HexSense-MIT/HS_ESP32_CAM_module/README.md

# HS_ESP32_CAM_module

A custom designed USB camera module, with ESP32-S3R8 + OV2640. This will be used for the HexSense_CAM payload.
