HexSense-MIT/HS_ESP32_CAM_module/Docs/camera_pwr_consum.png

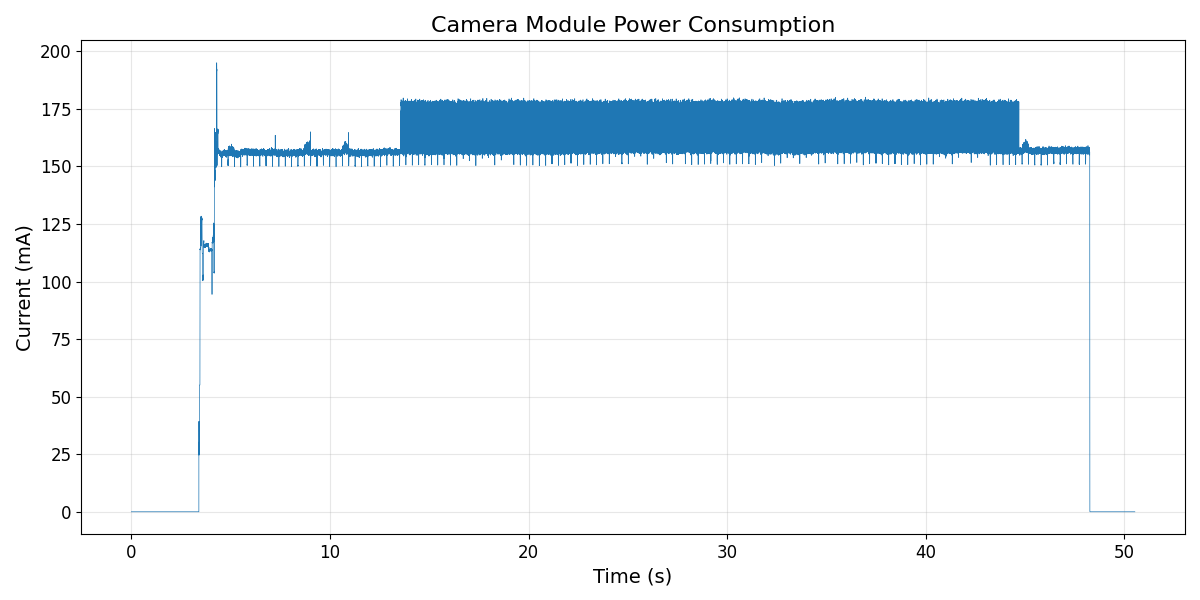
Docs/camera_pwr_consum.png
