HexSense-MIT/HS_ESP32_CAM_module/GUI/control_cam/1 - 5.tif

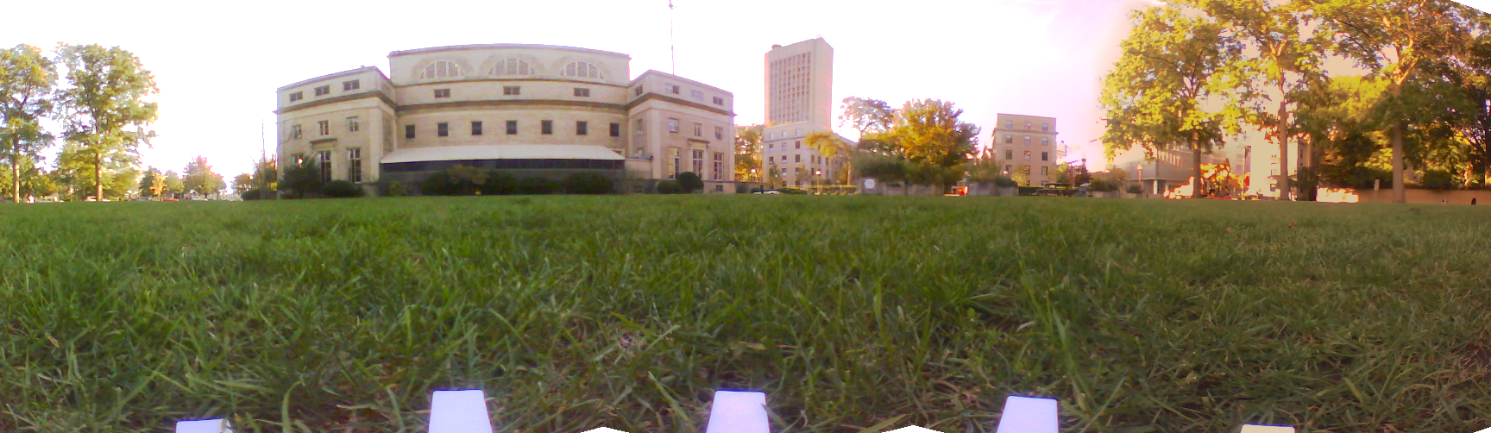
GUI/control_cam/1 - 5.tif
