HexSense-MIT/HS_ESP32_CAM_module/GUI/control_cam/images/1/02.jpg

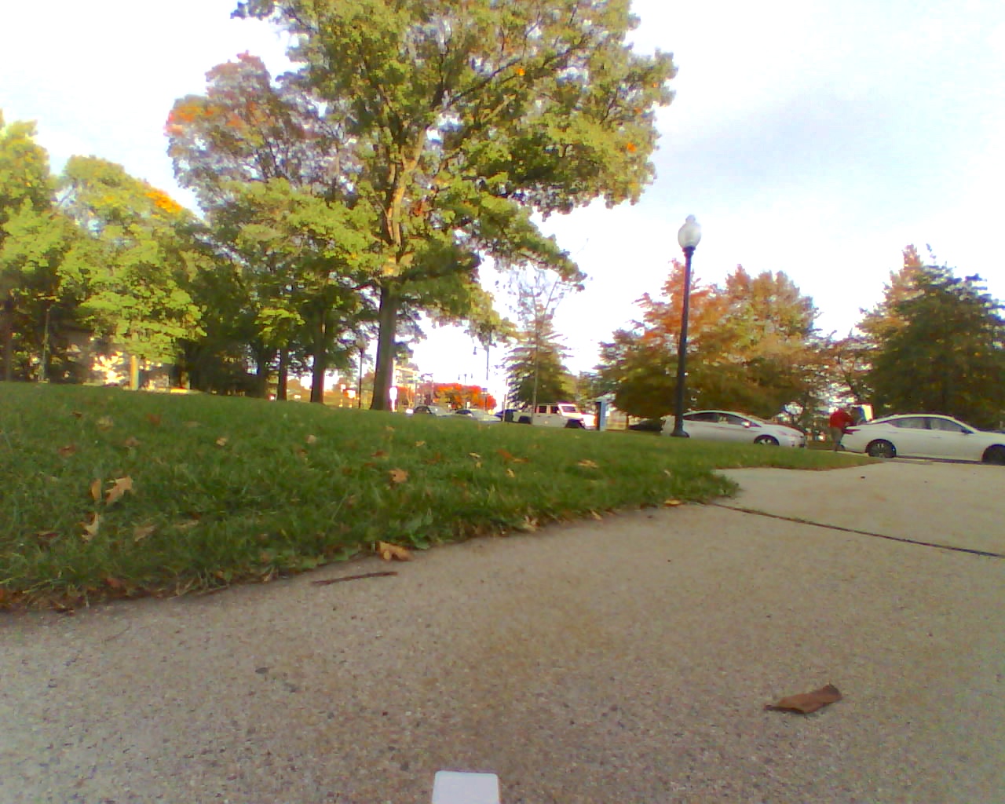
GUI/control_cam/images/1/02.jpg
