HexSense-MIT/HS_ESP32_CAM_module/GUI/control_cam/images/1/06.jpg

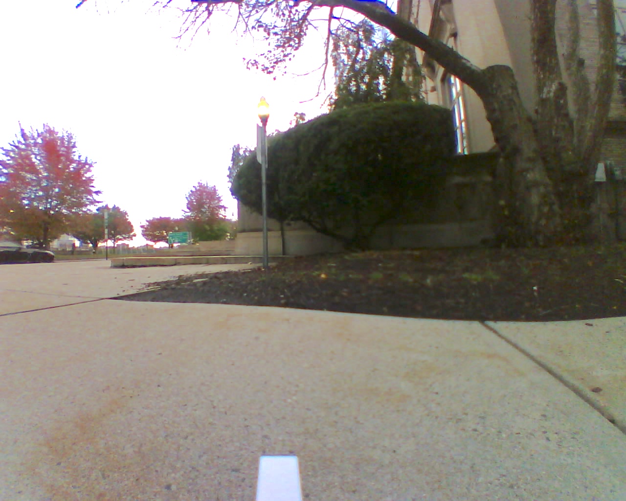
GUI/control_cam/images/1/06.jpg
