HexSense-MIT/HS_ESP32_CAM_module/GUI/control_cam/images/2/13.jpg

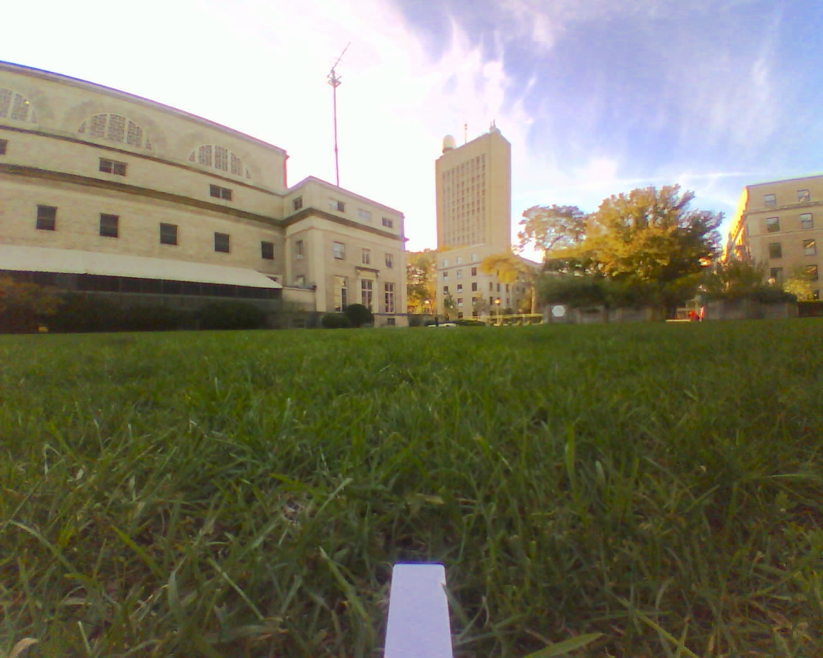
GUI/control_cam/images/2/13.jpg
