HexSense-MIT/HS_ESP32_CAM_module/GUI/control_cam/images/lab_open_desk/10.jpg

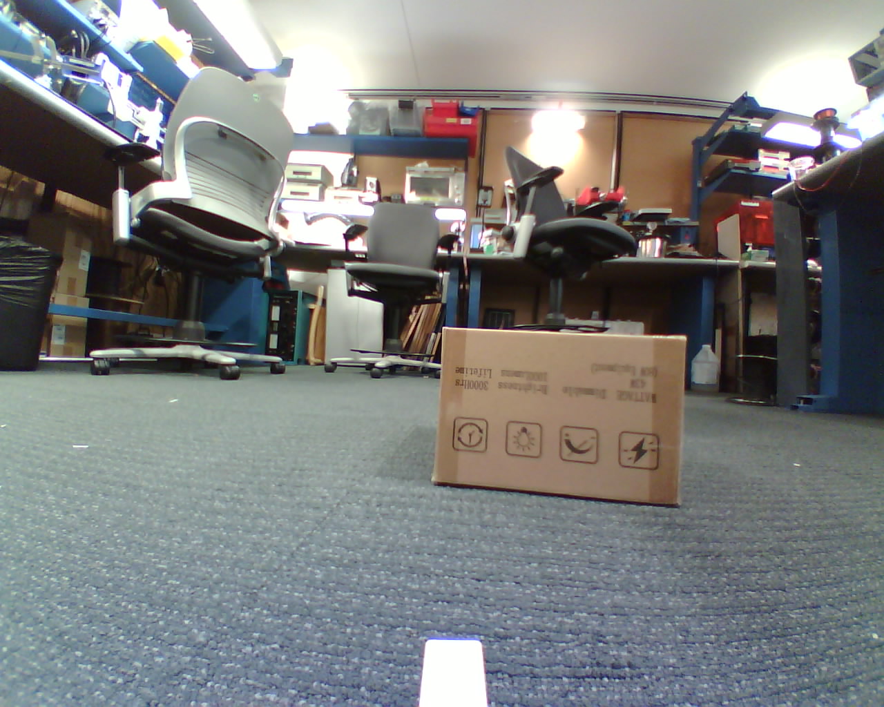
GUI/control_cam/images/lab_open_desk/10.jpg
