HexSense-MIT/HS_ESP32_CAM_module/GUI/control_cam/images/MIT.jpg

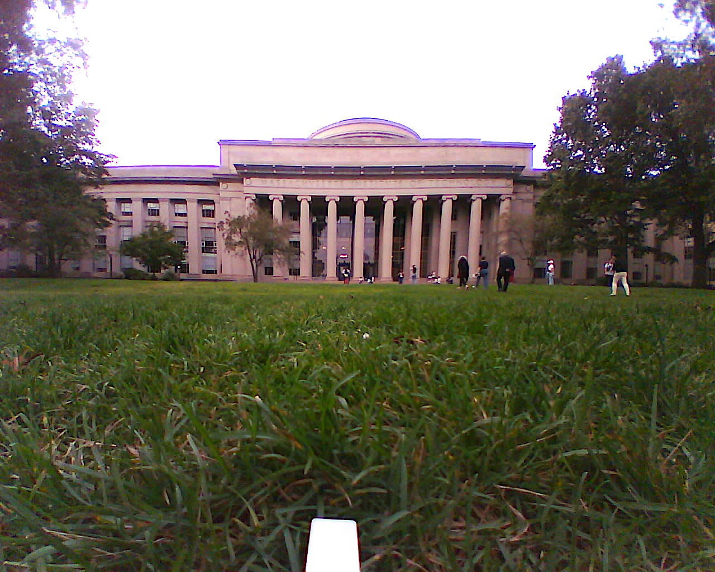
GUI/control_cam/images/MIT.jpg
