HexSense-MIT/HS_ESP32_CAM_module/GUI/control_cam/images/parkinglot/11.jpg

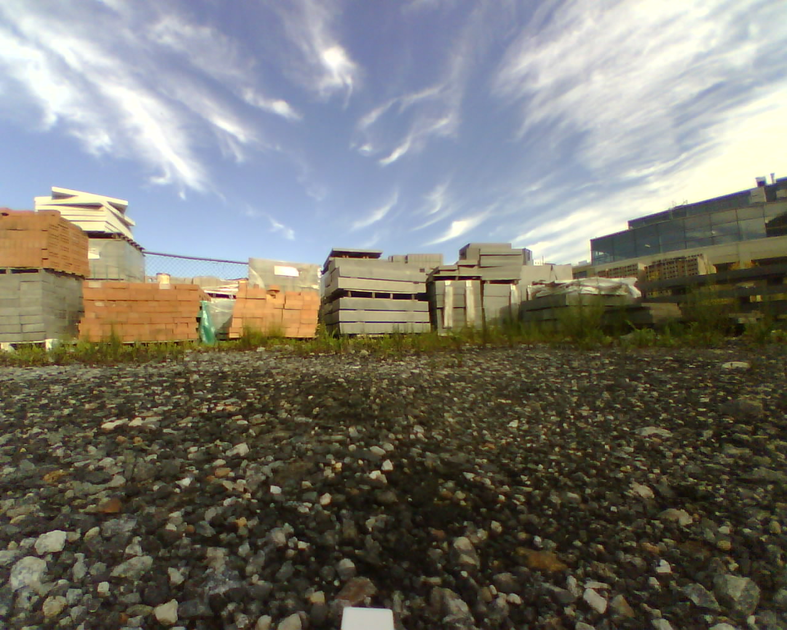
GUI/control_cam/images/parkinglot/11.jpg
