HexSense-MIT/HS_ESP32_CAM_module/GUI/control_cam/images/parkinglot/19.jpg

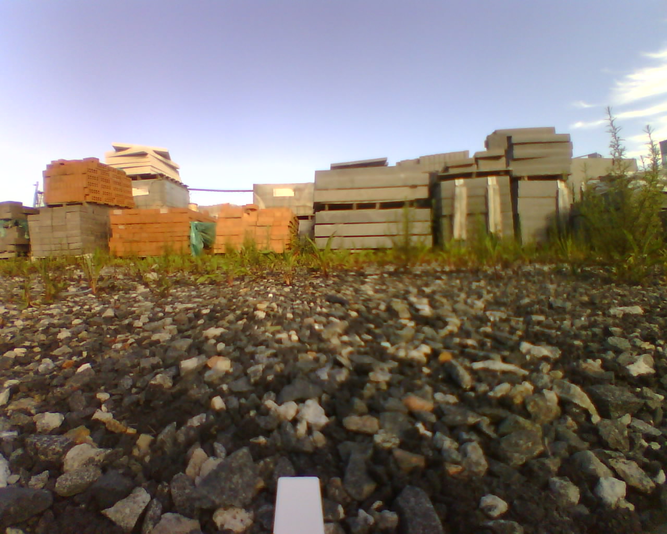
GUI/control_cam/images/parkinglot/19.jpg
