HexSense-MIT/HS_ESP32_CAM_module/GUI/control_cam/output_image.jpg

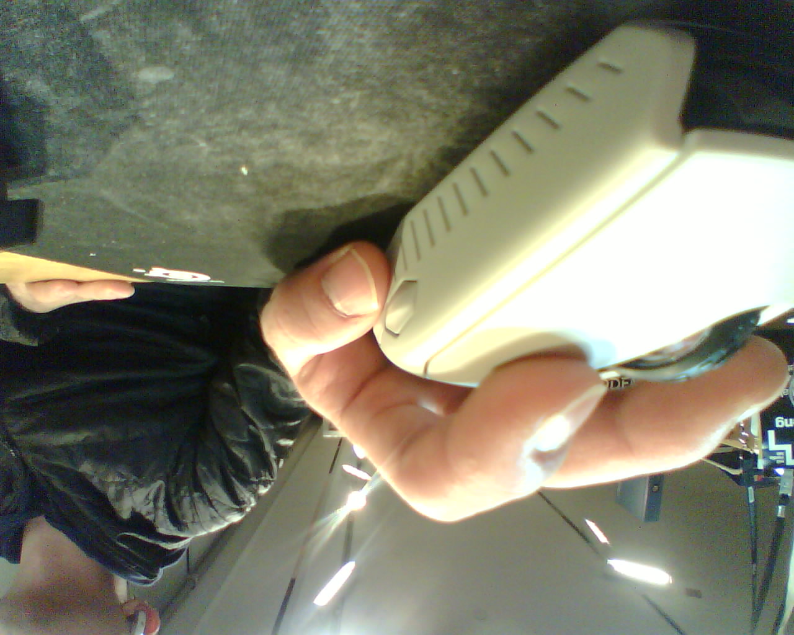
GUI/control_cam/output_image.jpg
