HexSense-MIT/HS_ESP32_CAM_module/GUI/control_cam/xy.jpeg

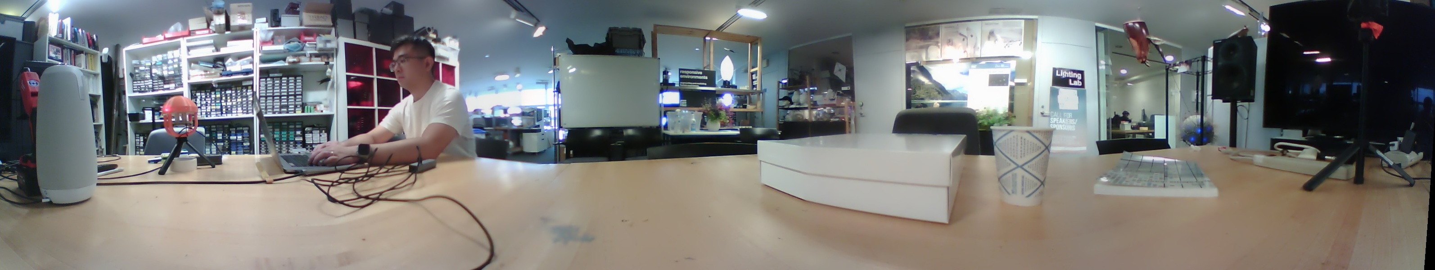
GUI/control_cam/xy.jpeg
