HexSense-MIT/HS_ESP32_CAM_module/GUI/moonpano/1/0.jpg

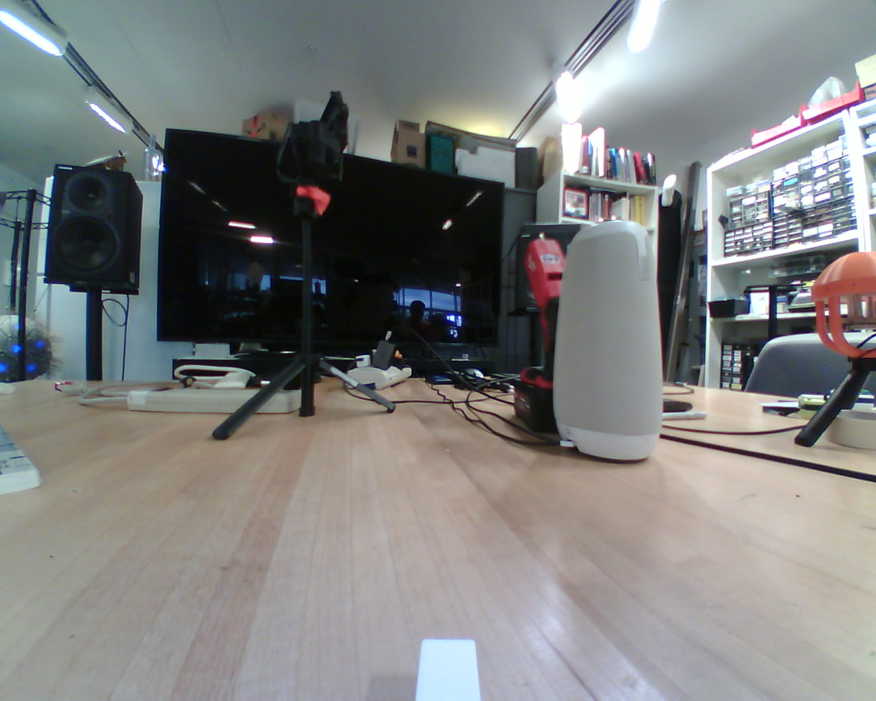
GUI/moonpano/1/0.jpg
