HexSense-MIT/HS_ESP32_CAM_module/GUI/moonpano/1/1.jpg

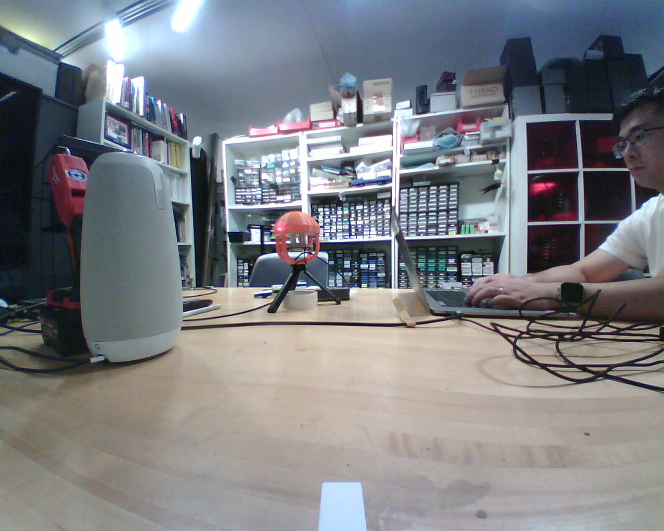
GUI/moonpano/1/1.jpg
