HexSense-MIT/HS_ESP32_CAM_module/GUI/moonpano/calib.jpg

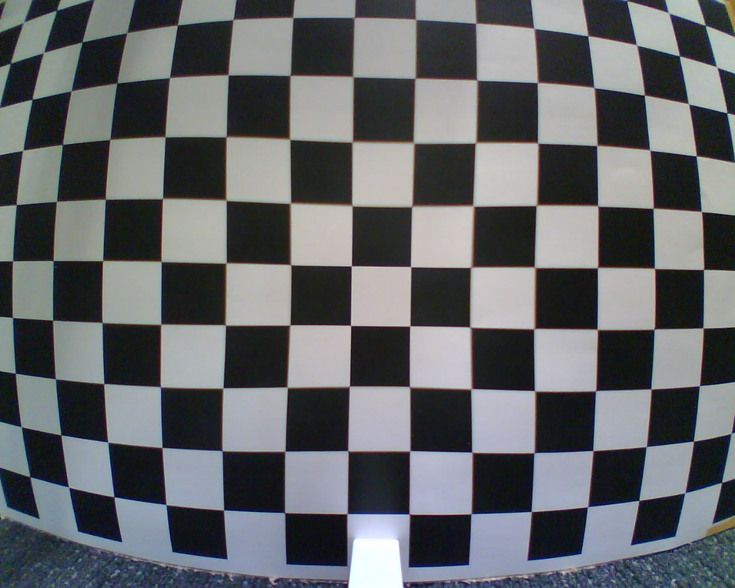
GUI/moonpano/calib.jpg
