HexSense-MIT/HS_ESP32_CAM_module/GUI/moonpano/map.png

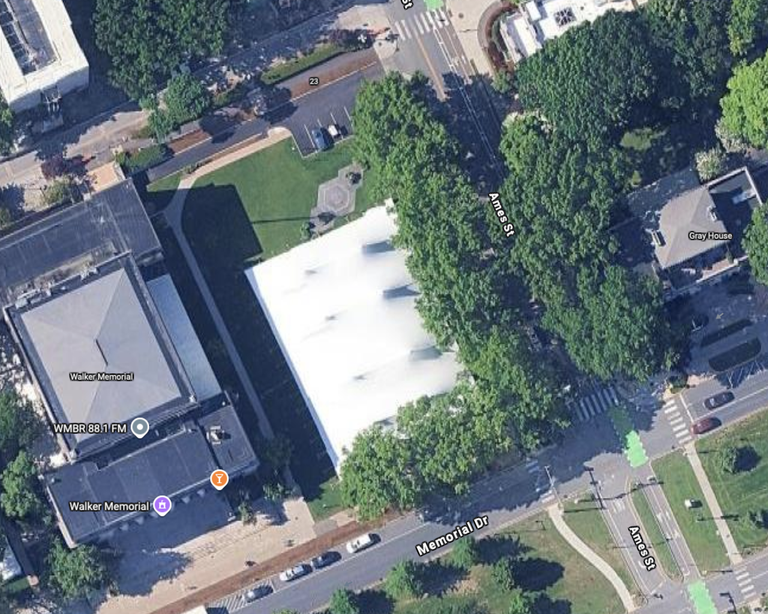
GUI/moonpano/map.png
