HexSense-MIT/HS_ESP32_CAM_module/GUI/control_cam/calibration/cali_code/9.jpg

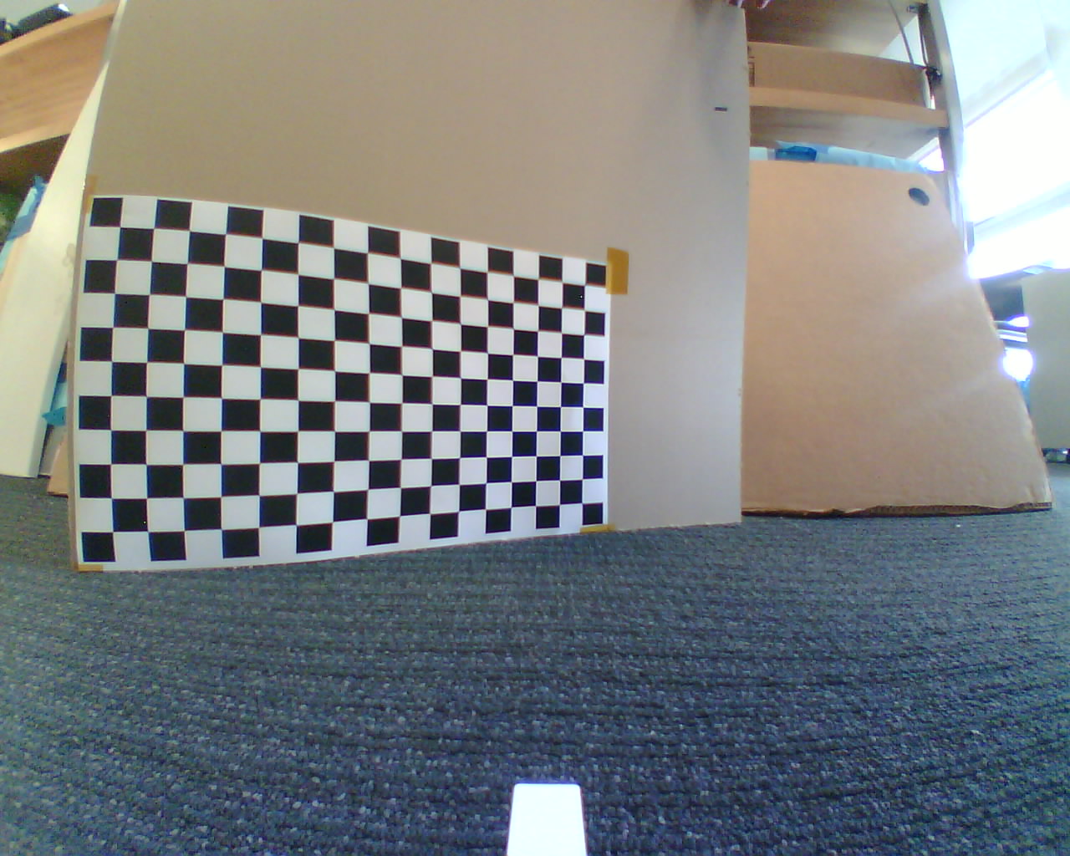
GUI/control_cam/calibration/cali_code/9.jpg
