HexSense-MIT/HS_ESP32_CAM_module/GUI/control_cam/calibration/cali_code/23.jpg

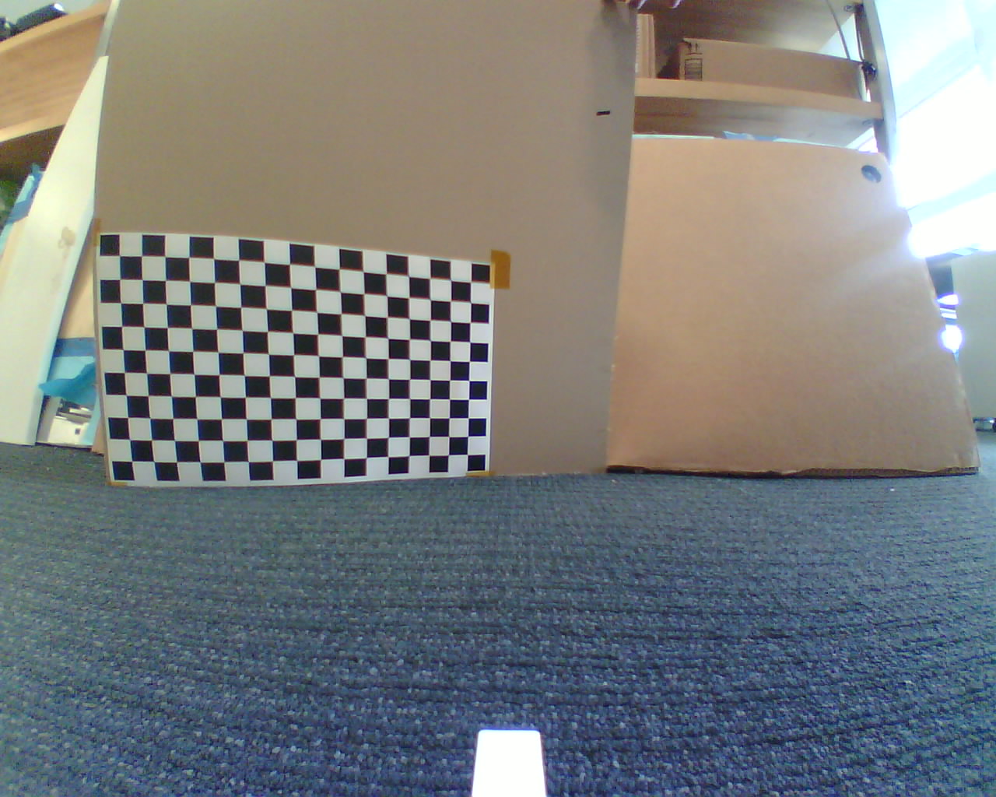
GUI/control_cam/calibration/cali_code/23.jpg
