HexSense-MIT/HS_ESP32_CAM_module/GUI/control_cam/calibration/cali_code/detected_corners_13.jpg

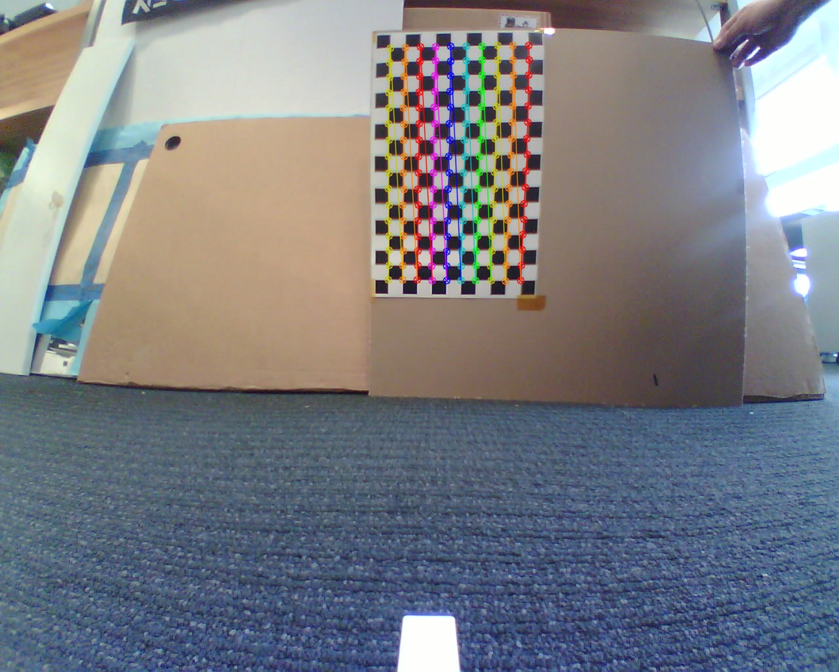
GUI/control_cam/calibration/cali_code/detected_corners_13.jpg
