HexSense-MIT/HS_ESP32_CAM_module/GUI/control_cam/calibration/cali_code/VFoC_88_74_degree.jpg

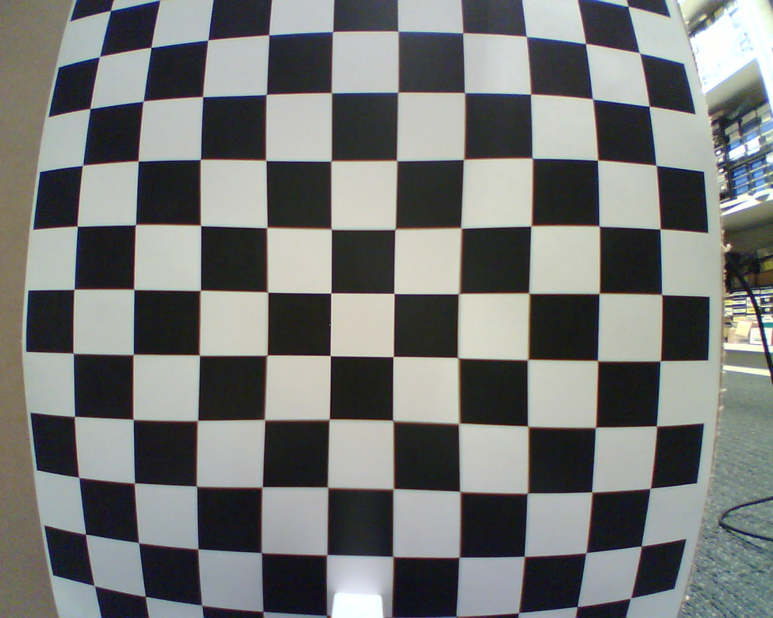
GUI/control_cam/calibration/cali_code/VFoC_88_74_degree.jpg
