HexSense-MIT/HS_ESP32_CAM_module/GUI/control_cam/calibration/calibrated_image/3_normalized_image.jpg

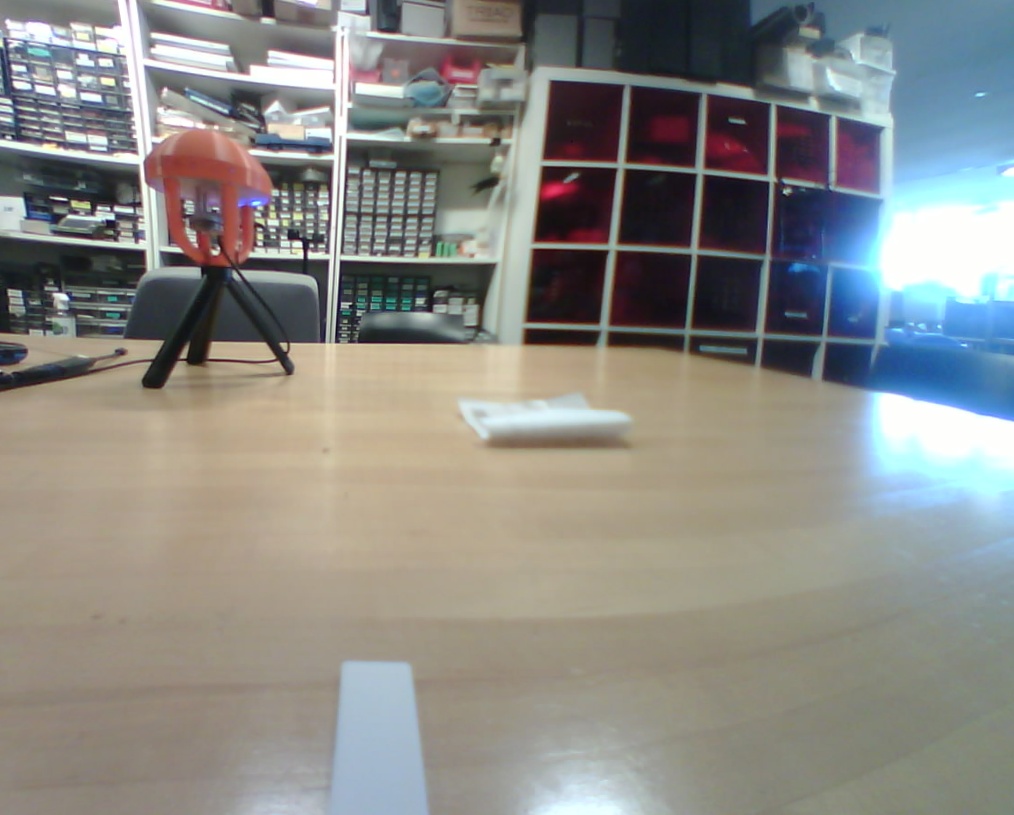
GUI/control_cam/calibration/calibrated_image/3_normalized_image.jpg
