HexSense-MIT/HS_ESP32_CAM_module/GUI/control_cam/calibration/calibrated_image/stitched.jpg

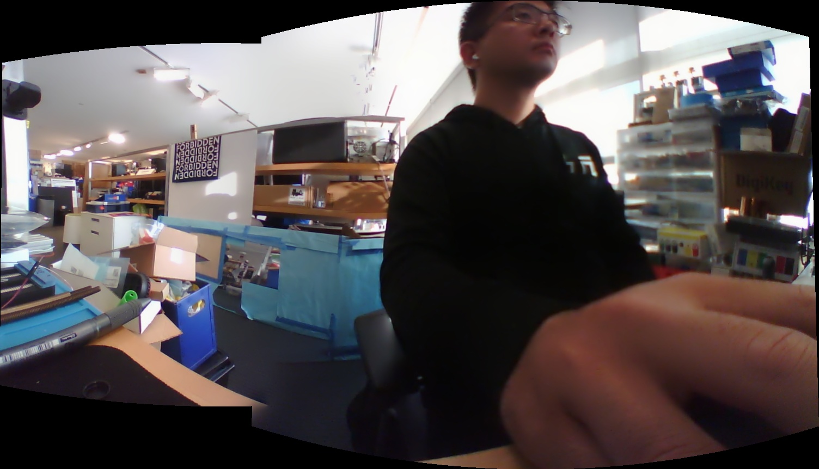
GUI/control_cam/calibration/calibrated_image/stitched.jpg
