HexSense-MIT/HS_ESP32_CAM_module/firmware/ESP32S3-CAM-HOST-W-GUI_PSRAM_MicroSD_Antarctica/src/main.cpp

// comm with GUI through USB.
// Store image data in PSRAM first then into SD card.
#include <Arduino.h>

#include "cam_system.h"
#include "cam_comm.h"
#include <FS.h>
#include <SD_MMC.h>
#include <esp_sleep.h>

int     current_cam_num = 1; // Default camera number
int32_t file_name_num   = 1;
constexpr uint64_t LIGHT_SLEEP_US = 300ULL * 1000000ULL; // 10 seconds

void enter_light_sleep(uint64_t sleep_us) {
  esp_sleep_enable_timer_wakeup(sleep_us);
  esp_light_sleep_start(); // Returns after wake-up
}

void setup() {
  system_init();
}

void loop() {
  turnoffallcams();
  enter_light_sleep(LIGHT_SLEEP_US);

  current_cam_num = 1;

  while (current_cam_num < 7) {
    turn_on_a_camera(current_cam_num);
    take_photos(5);

    char filename[20];
    sprintf(filename, "/%d.jpg", file_name_num);
    // Ensure unique filename
    while (SD.exists(filename)) {
      file_name_num ++;
      sprintf(filename, "/%d.jpg", file_name_num);
    }
    store_img2sd(filename);

    turn_off_a_camera(current_cam_num);

    current_cam_num ++;
  }

  // Enter light sleep instead of busy waiting to lower power consumption between captures
  // enter_light_sleep(LIGHT_SLEEP_US);

  // if (update_comm()) {
  //   handle_cmd();
  // }
}
