HexSense-MIT/HS_ESP32_CAM_module/GUI/control_cam/HEX2IMG.py

import binascii

# Example HEX string (truncated for illustration)
hex_string = "FFD8FFE000104A46494600010101000000000000FFDB0043000403030403030404030405040405060A07060606060C0909070A0F0D0F0F0E0D0E0E10121714101116110E0E141B141618191A1A1A10131C1E1C191E17191A19FFDB0043010405050605060C07070C19110E111919191919191919191919191919191919191919191919191919191919191919191919191919191919191919191919191919FFC4001F0000010501010101010100000000000000000102030405060708090A0BFFC400B5100002010303020403050504040000017D01020300041105122131410613516107227114328191A1082342B1C11552D1F02433627282090A161718191A25262728292A3435363738393A434445464748494A535455565758595A636465666768696A737475767778797A838485868788898A92939495969798999AA2A3A4A5A6A7A8A9AAB2B3B4B5B6B7B8B9BAC2C3C4C5C6C7C8C9CAD2D3D4D5D6D7D8D9DAE1E2E3E4E5E6E7E8E9EAF1F2F3F4F5F6F7F8F9FAFFC4001F0100030101010101010101010000000000000102030405060708090A0BFFC400B51100020102040403040705040400010277000102031104052131061241510761711322328108144291A1B1C109233352F0156272D10A162434E125F11718191A262728292A35363738393A434445464748494A535455565758595A636465666768696A737475767778797A82838485868788898A92939495969798999AA2A3A4A5A6A7A8A9AAB2B3B4B5B6B7B8B9BAC2C3C4C5C6C7C8C9CAD2D3D4D5D6D7D8D9DAE2E3E4E5E6E7E8E9EAF2F3F4F5F6F7F8F9FAFFC00011080400050003012100021101031101FFDA000C03010002110311003F00F9119553EF6791FDEA6E15C02A723F98A39D9DEA5685AC01BF79D8508CACD8C61AB3D16A8A566046D39A00DE335352A2B1A7F118ABB7E6DA3B5373F30F5A54B9948CB934D07F39E6901049F9C8E29397BAD6E284B965A126F3D376F6CE7A530664E42F4EF9A14650DD9B4ECF507906C23EED34C8CF828377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
