HexSense-MIT/HS_ESP32_CAM_module/firmware/ESP32S3-CAM-HOST-W-GUI_PSRAM_MicroSD_Antarctica/src/cam_adapter.cpp

#include "cam_adapter.h"

SFE_PCA95XX io; // Global instance of the PCA95XX I2C expander

void camadapter_init(void) {
  Wire.begin(CAM_SDA_PIN, CAM_SCL_PIN); // Initialize I2C with specified SDA and SCL pins

  // Initialize the PCA95XX I2C expander
  if (io.begin(PCA9554_ADDRESS_21) == false) {
    // Serial.println("PCA95xx not detected. Please check wiring. Freezing...");
    while (true);
  }

  // Set all camera pins to OUTPUT mode
  for (int i = 0; i < 8; i++) {
    io.pinMode(i, OUTPUT);
  }

  // Serial.println("Camera adapter initialized.");
}

void turnoncam(uint8_t cam) {
  if (cam < 0 || cam >= 8) {
    // Serial.println("Invalid camera index. Must be between 0 and 7.");
    return;
  }

  // Set the corresponding pin to HIGH to turn on the camera
  io.digitalWrite(cam, HIGH);
}

void turnoffcam(uint8_t cam) {
  if (cam < 0 || cam >= 8) {
    // Serial.println("Invalid camera index. Must be between 0 and 7.");
    return;
  }

  // Set the corresponding pin to LOW to turn off the camera
  io.digitalWrite(cam, LOW);
}

void turnoffallcams(void) {
  // Turn off all cameras by setting all pins to LOW
  for (int i = 0; i < 8; i++) {
    io.digitalWrite(i, LOW);
  }
}

void flush_buffer(void) {
  while (Serial1.available()) {
    Serial1.read(); // Read and discard all available bytes in the serial buffer
  }
}
