HexSense-MIT/HS_ESP32_CAM_module/firmware/ESP32S3-CAM-HOST-W-GUI_PSRAM_MicroSD_Antarctica/src/cam_system.h

#pragma once

#include <Arduino.h>
#include <HardwareSerial.h>
#include <esp_heap_caps.h>

#include "cam_adapter.h"

#include "SD.h"
#include "SPI.h"
#include "FS.h"

#define CAM_RX_PIN 13
#define CAM_TX_PIN 12

#define SD_SCK   9
#define SD_MISO  40
#define SD_MOSI  41
#define SD_CS    42

extern void system_init(void);
