HexSense-MIT/HS_ESP32_CAM_module/(commit log)

2025-03-01 Mac: start PCB
    [ESP32_S3_CAM.kicad_pcb, ESP32_S3_CAM.kicad_sch]
2025-03-01 mac: working on the PCB
    [ESP32_S3_CAM.kicad_sch]
2025-03-08 Mac: working on PCB design
    [ESP32_S3_CAM.kicad_pcb, ESP32_S3_CAM.kicad_sch]
2025-04-09 mac: working on the cam pcb
2025-04-11 mac:working on the camera module PCB
    [ESP32_S3_CAM.kicad_pcb, ESP32_S3_CAM.kicad_sch]
2025-04-13 PC: almost done with the PCB design
    [ESP32_S3_CAM.kicad_pcb, ESP32_S3_CAM.kicad_sch]
2025-04-13 PC: finsihed camera brd
    [ESP32_S3_CAM.kicad_pcb, ESP32_S3_CAM.kicad_sch]
2025-04-13 PC: finished ESP32CAM board
    [ESP32_S3_CAM.kicad_pcb]
2025-04-14 PC: finished PCB
    [ESP32_S3_CAM.kicad_pcb]
2025-04-17 mac: nothing
    [ESP32_S3_CAM.kicad_pcb]
2025-04-18 PC: finsihed PCB design and ordered PCB
    [ESP32_S3_CAM-B_Cu.gbr, ESP32_S3_CAM-B_Mask.gbr, ESP32_S3_CAM-B_Paste.gbr, ESP32_S3_CAM-B_Silkscreen.gbr, ESP32_S3_CAM-Edge_Cuts.gbr, ESP32_S3_CAM-F_Cu.gbr, ESP32_S3_CAM-F_Mask.gbr, ESP32_S3_CAM-F_Paste.gbr]
2025-04-24 mac: fix a big problm, the I2C is not conencted
    [ESP32_S3_CAM.kicad_pcb, ESP32_S3_CAM.kicad_sch]
2025-04-25 mac: finished correction of PCB w/o WiFi
    [ESP32_S3_CAM.kicad_pcb]
2025-04-25 mac: added PCB with wifi
    [ESP32_S3_CAM-B_Cu.gbr, ESP32_S3_CAM-B_Mask.gbr, ESP32_S3_CAM-B_Paste.gbr, ESP32_S3_CAM-B_Silkscreen.gbr, ESP32_S3_CAM-Edge_Cuts.gbr, ESP32_S3_CAM-F_Cu.gbr, ESP32_S3_CAM-F_Mask.gbr, ESP32_S3_CAM-F_Paste.gbr]
2025-05-12 PC: nothing
    [ESP32_S3_CAM_wifi.kicad_pcb]
2025-05-20 mac: camera module takes photo now, keep working on this
2025-06-24 mac: the camera is working, can transmit data nack through usb
2025-06-24 mac: the camera is working, can transmit data nack through usb, a better UI
2025-09-04 mac: working on ESP32-CAM-HOST-W-LoRa
2025-09-06 mac: working on camera-lora firmware
2025-09-06 mac: LoRa working with ESP32S3R8N16 platform code
2025-09-09 mac: lora receiving seems not working, add a new lora-tst project to debug
    [GUI_w_LoRa.py, cam_adapter.cpp, cam_adapter.h, cam_comm.cpp, cam_comm.h, cam_system.cpp, cam_system.h, central_lora.cpp]
2025-09-09 mac: lora receive working, and hexsense sends back data, but seems GUI doesn't receive
    [GUI_w_LoRa.py, cam_comm.cpp, comm.cpp, main.cpp]
2025-09-11 mac: working on lora cam firmware, not stable, pictures are broken
    [GUI_w_LoRa.py, cam_comm.cpp, cam_comm.h, cam_system.cpp, plot_0x00_position.py, post_proc.py, post_proc_raw.py]
2025-09-15 pc: changed something in PCB, nothing important
    [ESP32_S3_CAM.kicad_sch]
2025-10-14 pc: added python code for calibration
2025-10-14 pc: finished camera calibration
2026-01-10 firmware for HexSense camera Antactica field expedition working.
    [camera_module_pwr_consum.csv]
2026-01-11 firmware for HexSense camera Antactica field expedition working. changed the timing.
